allefenes/ParallelDeltaRobot/DeltaRobotV2/docs/guvenlik-gereksinimleri.md

# Güvenlik gereksinimleri ve izlenebilirlik

Her güvenlik gereksinimi en az bir otomatik testle kanıtlanır. Test plan risk tabanlıdır: kapsama yüzdesi bilgi amaçlıdır, asıl ölçüt bu tablodur. Gereksinim ancak ilgili katmanların hepsinde testi geçtiğinde "kanıtlandı" sayılır.

Katmanlar: **Ç** çekirdek (`core/`, F1), **S** sunucu 1. kapı (`ros2_ws/src/delta_server`, F3), **K** Pi kenarı son kapı (`edge/`, F3), **D** donanım kabul testi (F5, [kabul-testleri.md](kabul-testleri.md)). **U** uçtan uca Compose testi (`tools/e2e.sh`, F3) ek kanıttır.

Test adları gereksinim numarasıyla başlar; tam liste `grep -r "G5_" edge/tests ros2_ws/src/delta_server/test` ile çıkar.

| No  | Gereksinim | Katman  | Kanıtlayan testler (örnek) | Durum |
| --- | --- | --- | --- | --- |
| G1  | Motor açı limiti (−70° … +150°) dışındaki hiçbir açı servolara ulaşmaz | Ç, S, K | `Kinematics.MotorLimitRejected`; `test_G1_motor_limit_rejected*`; `Gate.G1_JointLimitExactEdgesAccepted`, `Edge.G1_LimitEdgesReachableNothingBeyondReachesDriver` (6); U: son kapı reddi | ✔ |
| G2  | Rot başı yanal açısı 13°'yi aşan konum kabul edilmez | Ç, S | `Kinematics.RodTiltLimitRejected`; `test_G2_rod_tilt_rejected`; launch_testing G2 reddi; U: 1. kapı reddi | ✔ |
| G3  | Erişilemeyen hedef reddedilir, hareket başlamaz | Ç, S | `Kinematics.UnreachablePointRejected`; `test_G3_*` (4) | ✔ |
| G4  | NaN, sonsuz ya da bozuk veri motorlara ulaşmaz | Ç, S, K | `Kinematics.NonFiniteInputRejected`; `test_G4_*` (5); `Gate.G4_*`, `FuzzRegressions.G4_CorpusAndRegressionInputsAreSafe` (7); libFuzzer ~175 bin girdi, bulgu yok | ✔ |
| G5  | Eklem hız ve ivme sınırları aşılamaz (aşan yörünge reddedilir) | S, K | `test_G5_*` (4), `test_auto_duration_respects_g5_limits`; `Gate.G5_*` (9) | ✔ |
| G6  | Sunucu kalp atışı kesilirse robot hareketin ortasında bile en geç T_stop içinde durup konumu tutar | K, U | `Edge.G6_*` (5); U: hareket ortasında kalp atışı kaybı, kara delik, sunucu çökmesi (HOLD ölçülen ~209 ms) | ✔ (yazılım), D: H2 F5 |
| G7  | Kalp atışı T_off süresince gelmezse tork kapanır ve elektromıknatıs tanımlı güvenli duruma geçer | K, U | `Edge.G7_*` (4); U: TORQUE_OFF ölçülen ~1029 ms; Pi SIGTERM'de tork + mıknatıs kapanır | ✔ (yazılım), D: H2 F5 |
| G8  | Kapıdan geçmeyen yörünge hiç başlamaz; neden sunucuya bildirilir | K, U | `Edge.G8_*` (5); U: 1. kapıyı atlayan limit dışı yörünge → `fault`, robot hareketsiz | ✔ |
| G9  | Sıcaklık, yük ya da gerilim sınırı aşılınca hareket durur | K | `Edge.G9_*` (10, MockDriver ile) | ✔ (yazılım), D: F5 |
| G10 | Seri hattı yalnız kenar servisi kullanır (tek sahip) | K | `Architecture.G10_*` (2, kaynak taraması) | ✔ |
| G11 | Kullanıcı kodu sandbox'ta ağa çıkamaz, kaynak sınırını aşamaz, dosya sistemine yazamaz | S | `sandbox/tests/g11/test_G11_*` 59 (gerçek konteyner: ağ, dosya sistemi, bellek, süreç, CPU, çıktı, yetki, koşucu protokolü), `test_job_backpressure` (Docker'sız tıkanma regresyonu); uçtan uca: sandbox ağsız, sonsuz döngü zaman aşımı | ✔ |
| G12 | Fiziksel acil stop, yazılımdan bağımsız olarak servo gücünü keser | D | F5 kabul testi H1 | F5 |
| G13 | Pi çöker ya da donarsa servo gücü donanımca en geç 0.5 s içinde kesilir (varsayım) | K, D | K: `LifePulse.G13_*` (3, darbe döngü ölünce durur); D: F5 kabul testi H13 | K ✔, D F5 |
| G14 | Mıknatıs ucu (P − 15 mm) tabla/zemin üst yüzünün altına inemez (çarpışma); sınır robot.yaml'dan (zemin + tabla kalınlığı) | S | `test_G14_*` (3), simülasyon API testleri, Playwright `limit_rejections` | ✔ |

**Kapanış durumu (2026-11-12):** 12 / 14 gereksinim tüm yazılım katmanlarında testle kanıtlandı (G1–G11, G14). G13'ün yazılım tarafı kanıtlandı; G12 ve G13'ün donanım tarafı ile G6, G7, G9'un gerçek donanım süre ölçümleri F5 ile askıda.

**Durum (F3 sonu):** 10 / 13 gereksinim tüm yazılım katmanlarında testle kanıtlandı (G1–G10). G13'ün yazılım tarafı (yaşam darbesi) kanıtlandı, donanım tarafı F5'te. G11 F4'te, G12 F5'te. G6, G7 ve G9'un gerçek donanımdaki süre ölçümleri F5 kabul testlerindedir.

**Kritik modüllerde mutasyon skoru:** 130 / 131 (%99.2; kapı, bekçi, protokol). Kalan tek mutant eşdeğer (`gate.cpp:32`, sonucu değiştirmiyor).

## Süre değerleri

| Değer  | Ayar | Ölçülen (sanal Pi, Compose) | Not |
| --- | --- | --- | --- |
| T_stop | 200 ms (`edge/config/edge.yaml`) | ~209 ms | Telemetri aralığı 50 ms ölçüme eklenir |
| T_off  | 1000 ms | ~1029 ms | |
| G13 | 0.5 s (varsayım, 74HC123 RC) | F5 | Yaşam darbesi 100 Hz döngüde 50 Hz kare dalga |

**F4 eki:** G14 F4'te API sözleşmesi yazılırken bulundu: çalışma alanının kinematik alt sınırı (P −250 mm) mıknatıs ucunu zemine (−240) indirebiliyordu ve 1. kapıda zemin denetimi yoktu. Süpervizöre eklendi.
