allefenes/ParallelDeltaRobot/DeltaRobotV2/docs/img/cad/eklem.png

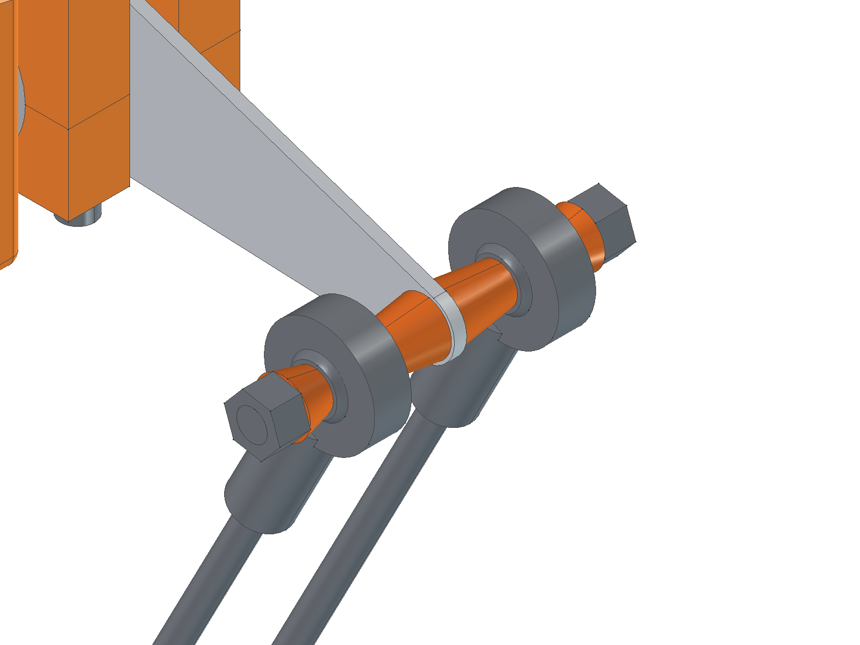
DeltaRobotV2/docs/img/cad/eklem.png
