allefenes/ParallelDeltaRobot/DeltaRobotV2/docs/img/cad/iso.png

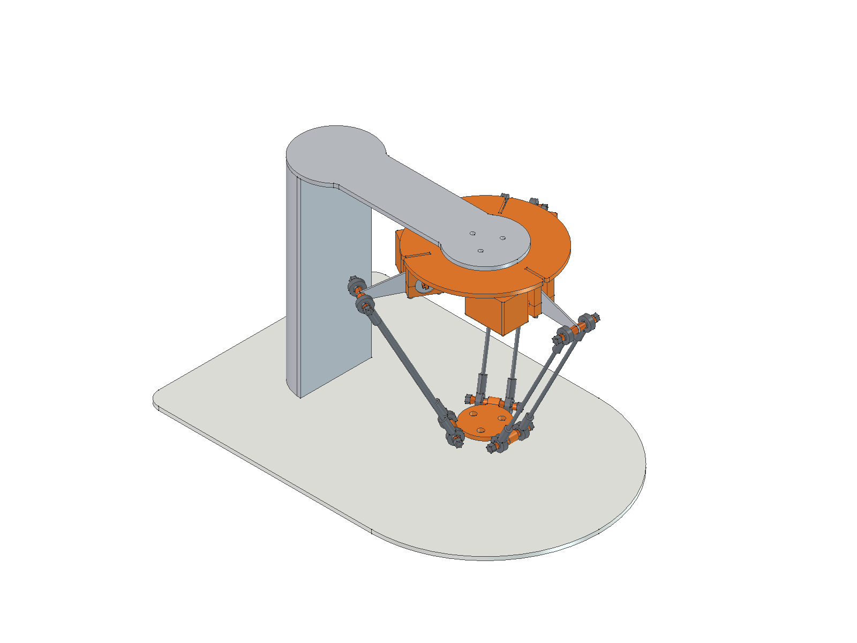
DeltaRobotV2/docs/img/cad/iso.png
