allefenes/ParallelDeltaRobot/DeltaRobotV2/docs/img/cad/kol1_yukari.png

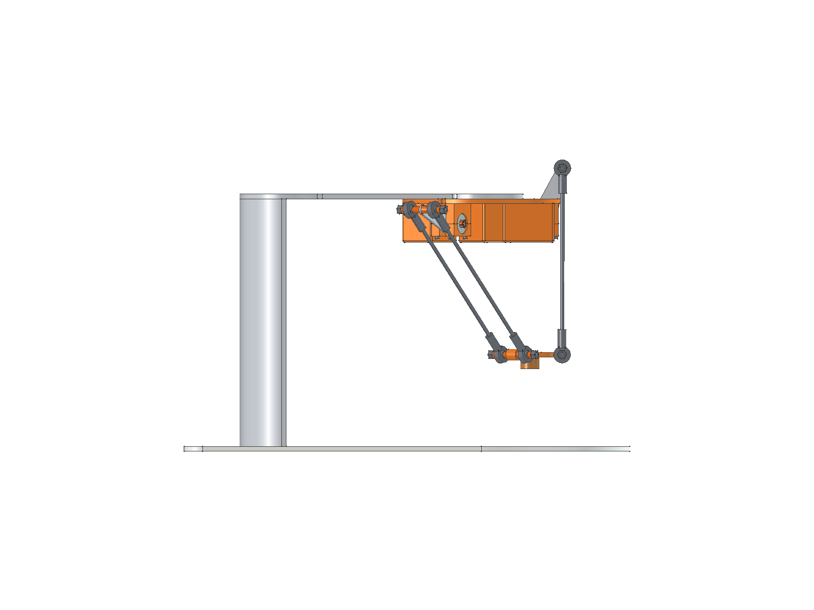
DeltaRobotV2/docs/img/cad/kol1_yukari.png
