allefenes/ParallelDeltaRobot/DeltaRobotV2/docs/img/cad/kol1_yukari_iso.png

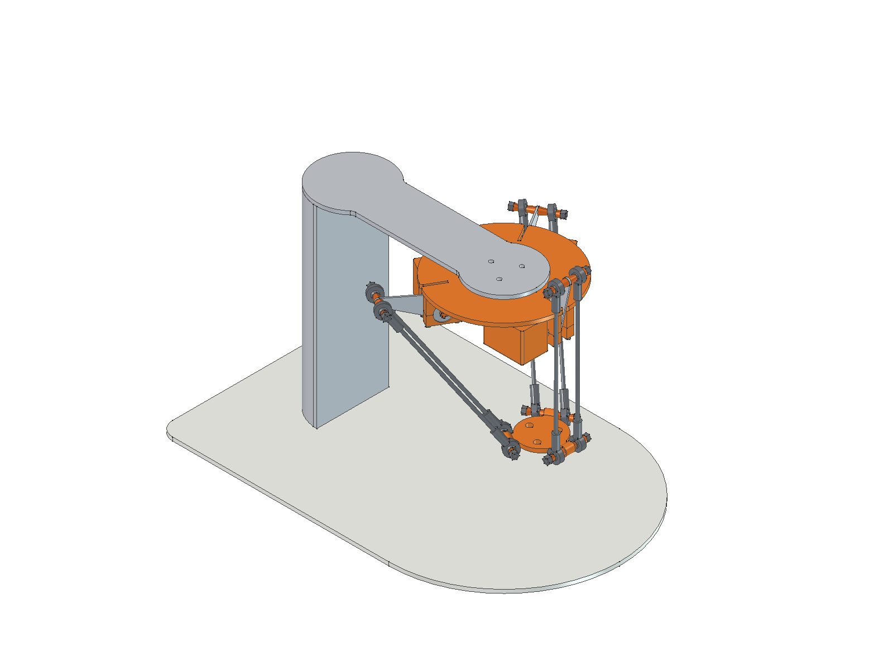
DeltaRobotV2/docs/img/cad/kol1_yukari_iso.png
