allefenes/ParallelDeltaRobot/DeltaRobotV2/docs/img/cad/kol1_yukari_yakin.png

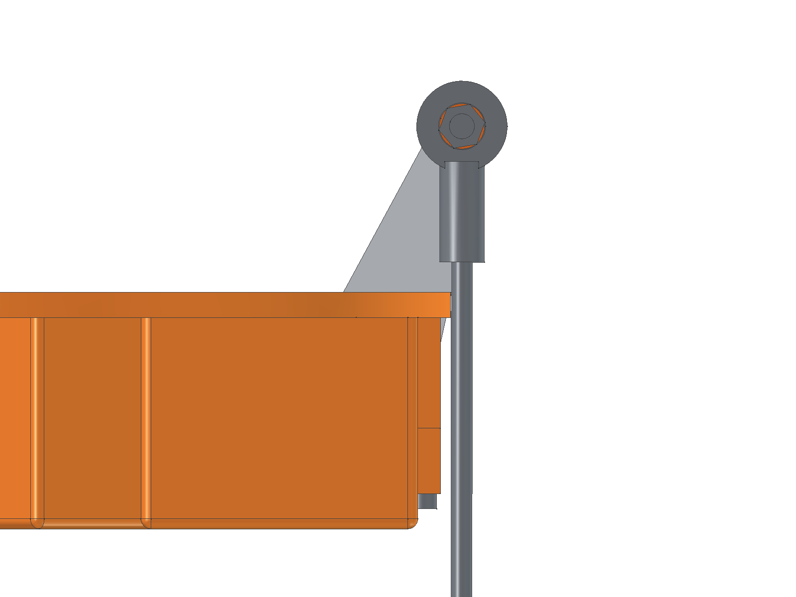
DeltaRobotV2/docs/img/cad/kol1_yukari_yakin.png
