allefenes/ParallelDeltaRobot/DeltaRobotV2/docs/img/cad/mekanizma.png

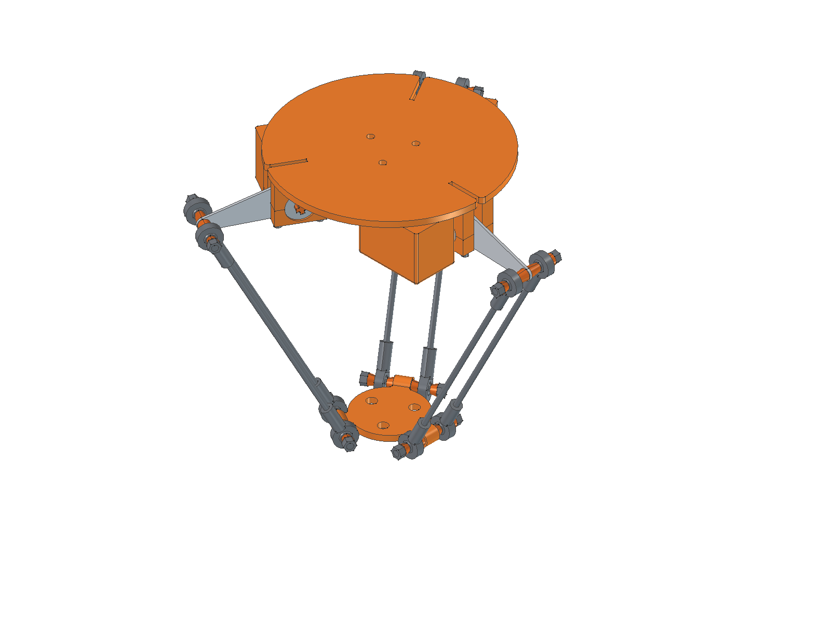
DeltaRobotV2/docs/img/cad/mekanizma.png
