allefenes/ParallelDeltaRobot/DeltaRobotV2/docs/img/cad/motor_kutulari_alttan.png

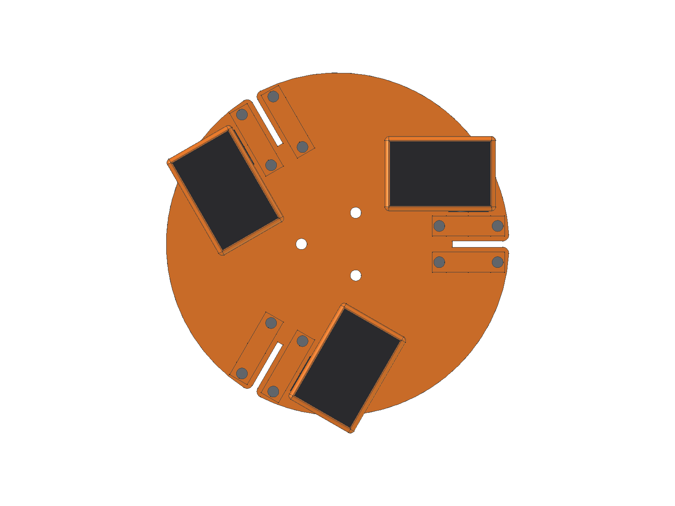
DeltaRobotV2/docs/img/cad/motor_kutulari_alttan.png
