allefenes/ParallelDeltaRobot/DeltaRobotV2/docs/img/cad/motor_kutusu_yakin.png

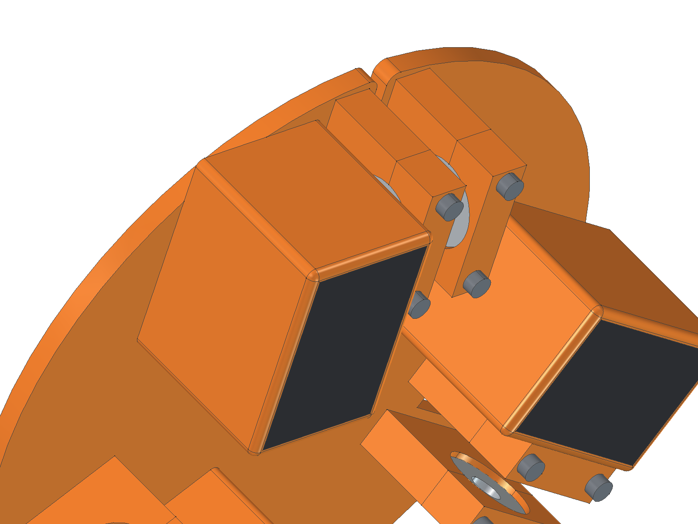
DeltaRobotV2/docs/img/cad/motor_kutusu_yakin.png
