allefenes/ParallelDeltaRobot/DeltaRobotV2/docs/img/cad/parcalar/01_pom_taban.png

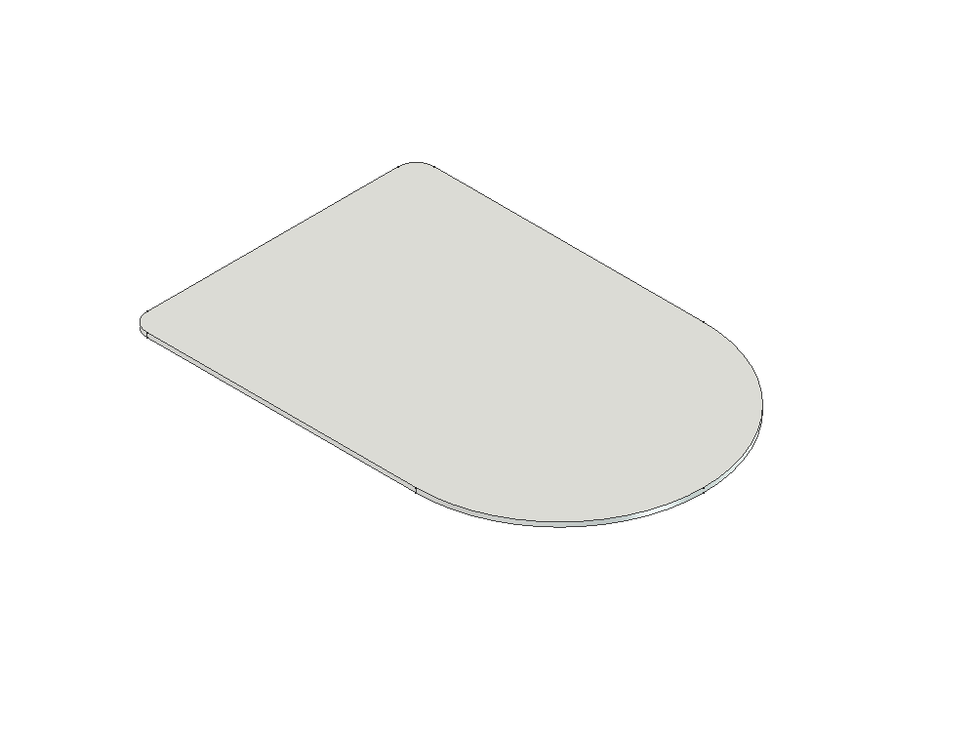
DeltaRobotV2/docs/img/cad/parcalar/01_pom_taban.png
