allefenes/ParallelDeltaRobot/DeltaRobotV2/docs/img/cad/parcalar/02_sutun_tavan.png

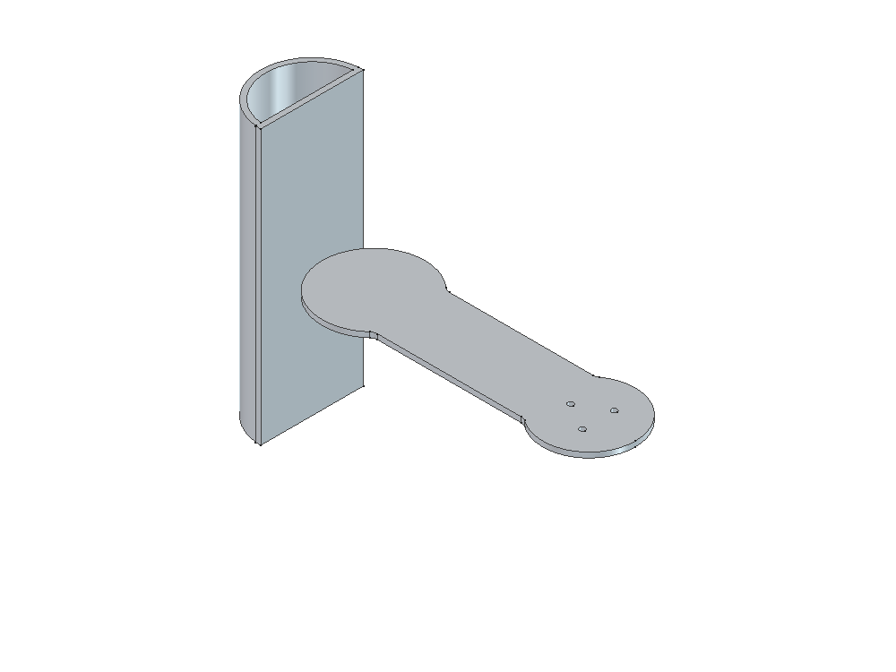
DeltaRobotV2/docs/img/cad/parcalar/02_sutun_tavan.png
