allefenes/ParallelDeltaRobot/DeltaRobotV2/docs/img/cad/parcalar/03_motor_govdesi.png

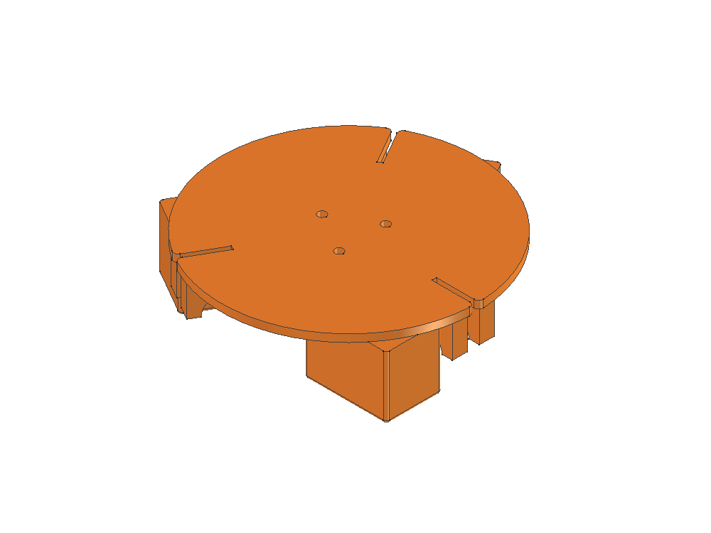
DeltaRobotV2/docs/img/cad/parcalar/03_motor_govdesi.png
