allefenes/ParallelDeltaRobot/DeltaRobotV2/docs/img/cad/parcalar/03_motor_govdesi_ust_plaka.png

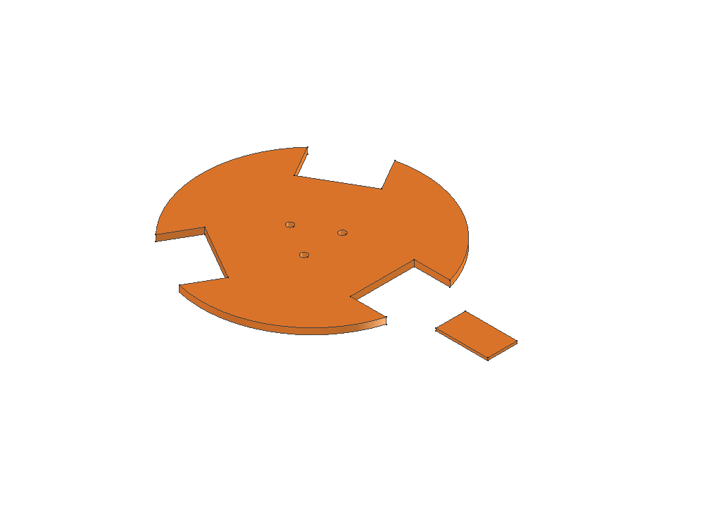
DeltaRobotV2/docs/img/cad/parcalar/03_motor_govdesi_ust_plaka.png
