allefenes/ParallelDeltaRobot/DeltaRobotV2/docs/img/cad/parcalar/04_rulman_kapagi_vida.png

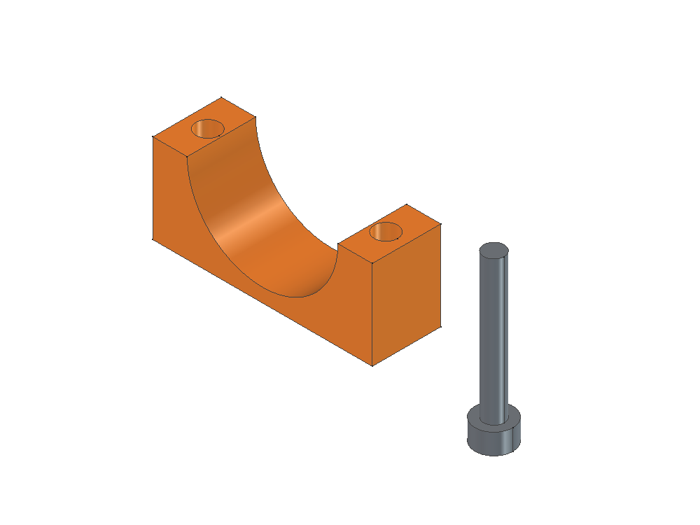
DeltaRobotV2/docs/img/cad/parcalar/04_rulman_kapagi_vida.png
