allefenes/ParallelDeltaRobot/DeltaRobotV2/docs/img/cad/parcalar/05_motor_rulman_mil.png

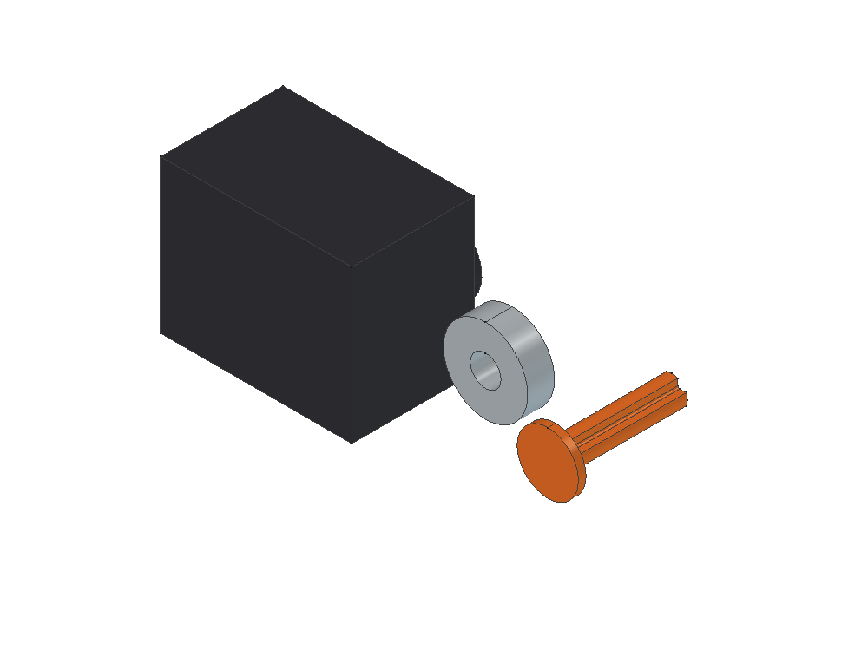
DeltaRobotV2/docs/img/cad/parcalar/05_motor_rulman_mil.png
