allefenes/ParallelDeltaRobot/DeltaRobotV2/docs/img/cad/parcalar/06_kisa_kol.png

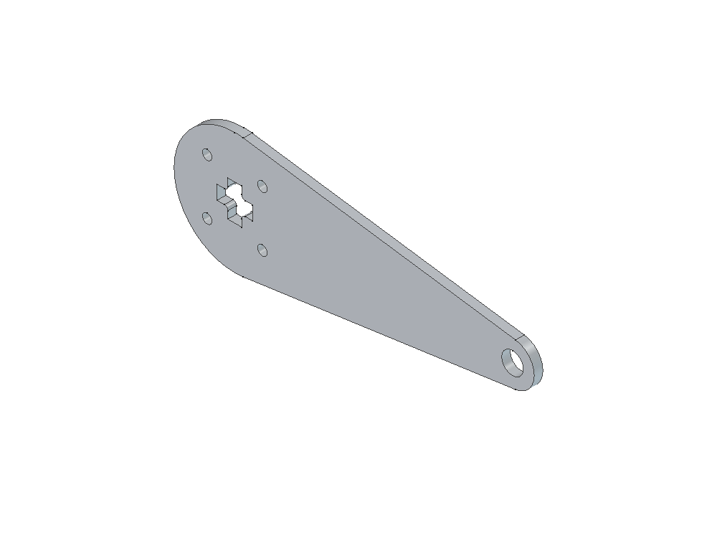
DeltaRobotV2/docs/img/cad/parcalar/06_kisa_kol.png
