allefenes/ParallelDeltaRobot/DeltaRobotV2/docs/img/cad/parcalar/07_eklem_pim_burc_somun_kure.png

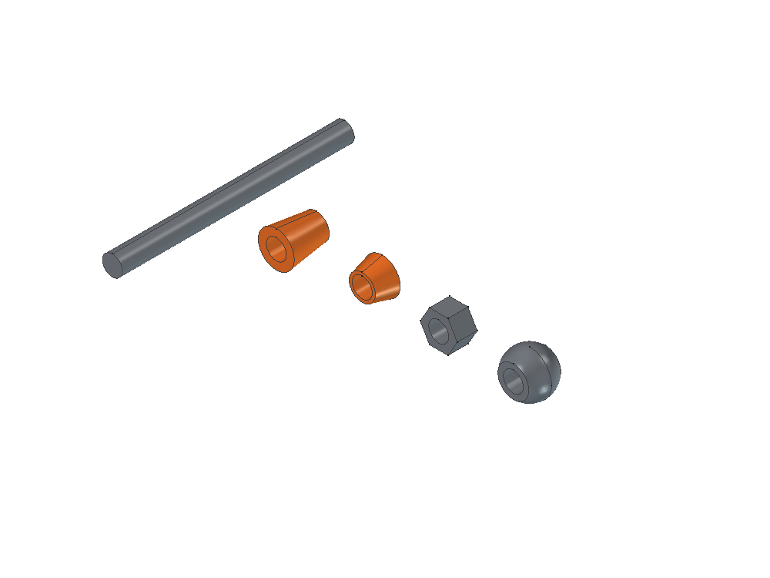
DeltaRobotV2/docs/img/cad/parcalar/07_eklem_pim_burc_somun_kure.png
