allefenes/ParallelDeltaRobot/DeltaRobotV2/docs/img/cad/parcalar/08_uzun_kol_rot_basi.png

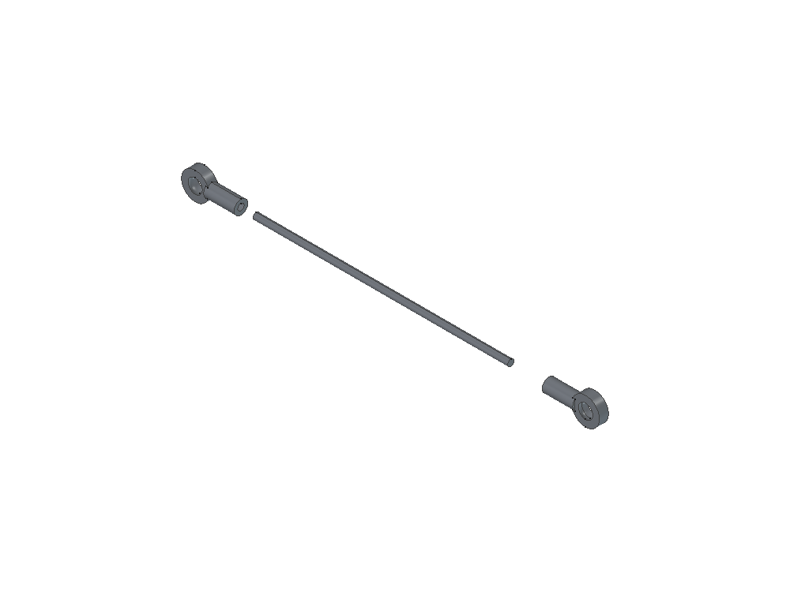
DeltaRobotV2/docs/img/cad/parcalar/08_uzun_kol_rot_basi.png
