allefenes/ParallelDeltaRobot/DeltaRobotV2/docs/img/cad/parcalar/09_platform_miknatis.png

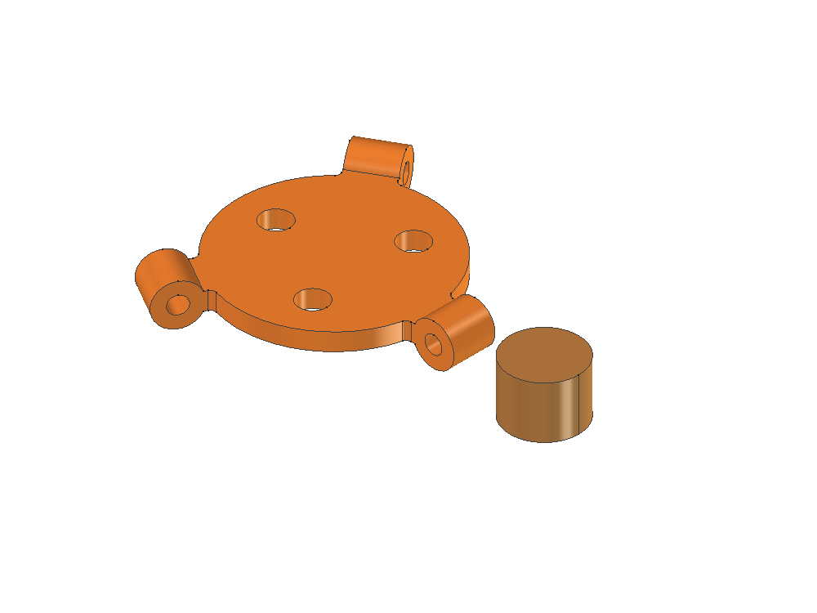
DeltaRobotV2/docs/img/cad/parcalar/09_platform_miknatis.png
