allefenes/ParallelDeltaRobot/DeltaRobotV2/docs/img/cad/ust.png

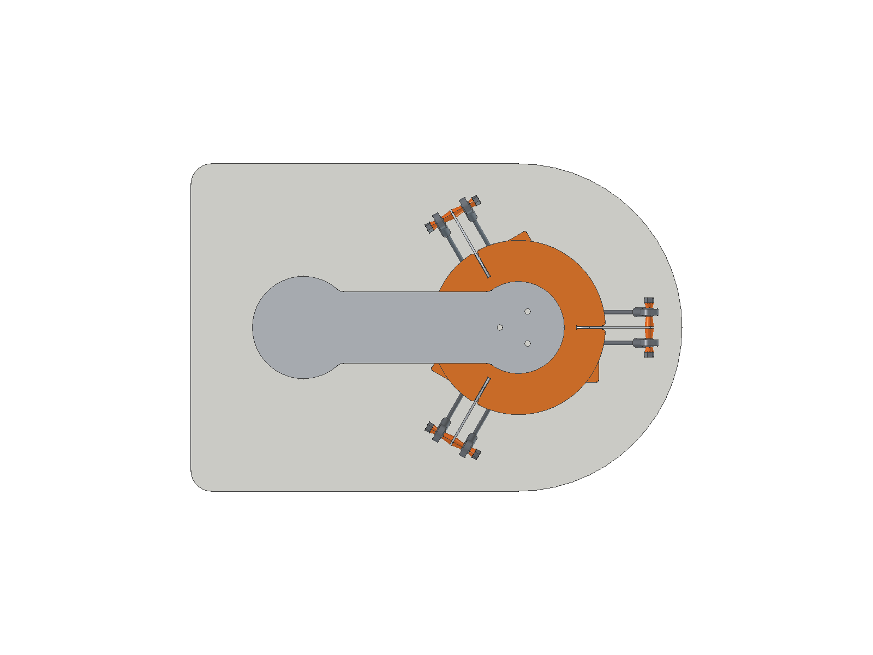
DeltaRobotV2/docs/img/cad/ust.png
