allefenes/ParallelDeltaRobot/DeltaRobotV2/docs/img/cad/yan.png

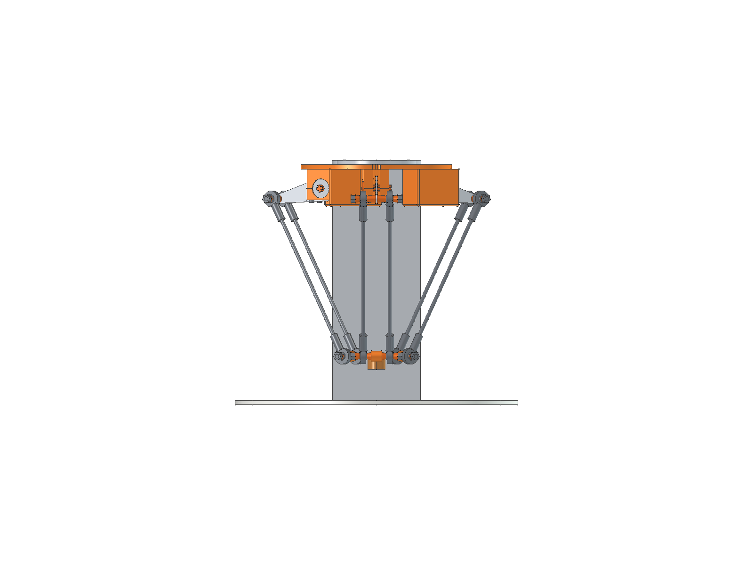
DeltaRobotV2/docs/img/cad/yan.png
