allefenes/ParallelDeltaRobot/DeltaRobotV2/ros2_ws/screenshots/01_home.png

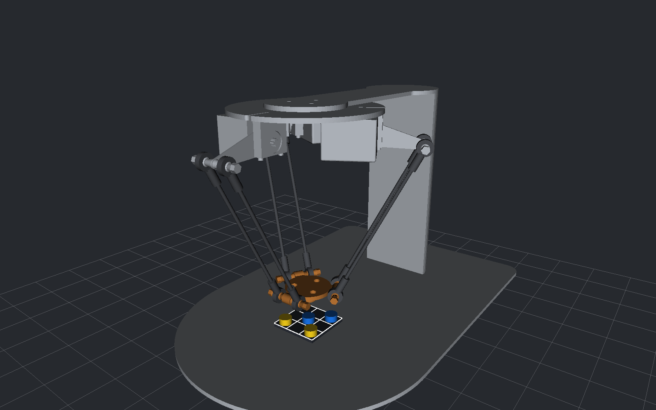
DeltaRobotV2/ros2_ws/screenshots/01_home.png
