allefenes/ParallelDeltaRobot/DeltaRobotV2/web/screenshots/ui.png

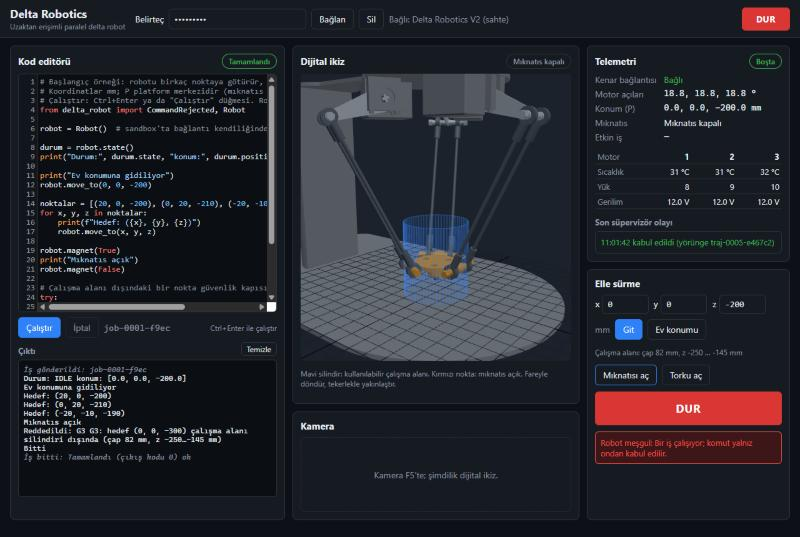
DeltaRobotV2/web/screenshots/ui.png
