allefenes/ParallelDeltaRobot/KilavuzDeltaRobotics/theme/hq720.png

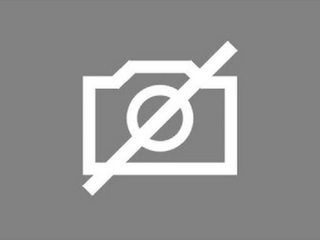
KilavuzDeltaRobotics/theme/hq720.png
