allefenes/ParallelDeltaRobot/DeltaRobotV2/hardware/bom.md

# Malzeme listesi (BOM)

Bu dosya üretilir; elle düzenlemeyin. Kaynak: [bom.yaml](bom.yaml) (elle tutulan alanlar) ve CAD (`cad/out/parts.json`: adet ve kütle). Makine okunur sürüm: [bom.csv](bom.csv).

Üretmek: `docker compose run --rm dev python3 tools/bom.py`

**Durum: F5 askıda (2026-11-12).** Hiçbir kalem satın alınmadı ya da üretilmedi. Elektronik kalemler (donanım bekçisi, mıknatıs sürücüsü, acil stop, Pi beslemesi) ve kutu/kamera tasarımı kesinleşmedi; fiyat ve tedarikçi alanları boştur.

| No  | Ad | Kategori | Malzeme / özellik | Adet | Birim kütle (g) | Toplam kütle (g) | Üretim | Tedarikçi | Birim fiyat (TL) | Durum | Kaynak | Not |
| --- | --- | --- | --- | ---- | --- | --- | --- | --- | --- | --- | --- | --- |
| 1 | POM taban | Gövde | POM, 5 mm levha | 1 | 1004.2 | 1004.2 | CNC / lazer kesim, köşeler R20 | TBD | | V1 (olduğu gibi) | CAD | Dış ölçüler varsayım |
| 2 | Sütun (D kesit) | Gövde | Al 7075, 5 mm | 1 | 897.4 | 897.4 | Lazer kesim + kıvırma + kaynak | TBD | | V1 (olduğu gibi) | CAD | 7075 kaynağa pek uygun değil; yeniden üretimde 6061/5083 |
| 3 | Tavan levhası | Gövde | Al 7075, 5 mm | 1 | 321.3 | 321.3 | Lazer kesim, geçişler R8; sütuna kaynaklı | TBD | | V1 (olduğu gibi) | CAD | Robot ucu R45 (varsayım) |
| 4 | Kısa kol | Gövde | Al 7075, 2 mm | 3 | 8.4 | 25.3 | Lazer kesim; artı delik iç köşeleri R0.8  | TBD | | V1 (olduğu gibi) | CAD | Merkezden merkeze 64 mm |
| 10  | Motor gövdesi (tek parça)  | 3B baskı | PLA, %20 doluluk | 1 | 116.0 | 116.0 | 3B baskı | kendi üretim | | V2'de değişti | CAD | Üst plaka + 3 motor kutusu + 6 rulman yatağı üst yarısı |
| 11  | Rulman yatağı alt kapağı | 3B baskı | PLA, %20 doluluk | 6 | 1.4 | 8.5 | 3B baskı | kendi üretim | | V1 (olduğu gibi) | CAD | Yatağın alt yarısı; alttan takılır, 2 vidayla alttan sıkılır |
| 12  | Çıkış mili (artı kesit) | 3B baskı | PLA, %100 doluluk | 3 | 1.9 | 5.8 | 3B baskı | kendi üretim | | V1 (olduğu gibi) | CAD | Uçları Ø8 dairede, 608ZZ'ye oturur |
| 13  | İç burç (konik) | 3B baskı | PLA %100 (varsayım) | 12 | 0.3 | 3.1 | 3B baskı ya da torna | kendi üretim | | V1 (olduğu gibi) | CAD | 6 × 10 mm (kısa kol) + 6 × 5 mm (platform); Ø9 → Ø6.5 |
| 14  | Dış burç (konik) | 3B baskı | PLA %100 (varsayım) | 12 | 0.2 | 2.0 | 3B baskı ya da torna | kendi üretim | | V1 (olduğu gibi) | CAD | 5 mm; dar ucu rot başına bakar |
| 15  | Uç platform | 3B baskı | PLA, %20 doluluk | 1 | 8.1 | 8.1 | 3B baskı | kendi üretim | | V1 (olduğu gibi) | CAD | R35 × 5 mm, 3 kulak, 3 süs deliği, mıknatıs cebi |
| 20  | Servo motor | Satın alma | Dynamixel AX-12A | 3 | 54.6 | 163.8 | satın alma | TBD | | V1 (olduğu gibi) | CAD | Yeniden kurulumda motor değişebilir |
| 21  | Rulman | Satın alma | 608ZZ (8 × 22 × 7) | 6 | 12.0 | 72.0 | satın alma | TBD | | V1 (olduğu gibi) | CAD | |
| 22  | Rot başı (dişi M5) | Satın alma | DIN ISO 12240-4 K, SI5 benzeri | 12 | 12.0 | 144.0 | satın alma | TBD | | V1 (olduğu gibi) | CAD | Kütle katalog değeri (~12 g) |
| 23  | Elektromıknatıs | Satın alma | Ø20 × 15 mm, 12 V (varsayım) | 1 | 35.0 | 35.0 | satın alma | TBD | | Varsayım | CAD | Model ve tutma kuvveti bilinmiyor |
| 30  | Uzun kol saplaması | Bağlantı elemanı | M5 saplama, çelik, 167 mm | 6 | 18.6 | 111.6 | Saplama kesimi | TBD | | V1 (olduğu gibi) | CAD | Rot başlarına 10'ar mm girer |
| 31  | Eklem pimi | Bağlantı elemanı | M5 saplama, çelik, ~60 mm | 6 | 8.9 | 53.6 | Saplama kesimi | TBD | | V2'de değişti | CAD | Yeni istif: 58 mm |
| 32  | Fiber somun | Bağlantı elemanı | M5 DIN 985 | 12 | 1.4 | 16.8 | satın alma | TBD | | V1 (olduğu gibi) | CAD | |
| 33  | Kapak vidası | Bağlantı elemanı | M3 × 20, alttan (varsayım) | 12 | 1.7 | 20.6 | satın alma | TBD | | Varsayım | CAD | |
| 34  | Gövde-tavan cıvatası | Bağlantı elemanı | M5 × 12 + somun (varsayım) | 3 | 3.0 | 9.0 | satın alma | TBD | | Varsayım | elle | CAD'de çizilmedi |
| 35  | Sütun-taban bağlantısı | Bağlantı elemanı | M5 cıvata + somun (varsayım) | 4 | 4.0 | 16.0 | satın alma | TBD | | Varsayım | elle | Bağlantı şekli bilinmiyor; CAD'de çizilmedi |
| 36  | Isıyla gömülen insert | Bağlantı elemanı | M3, pirinç, Ø4.6 × 5.7 mm (varsayım) | 12 | 0.5 | 5.5 | satın alma; havya ile PLA'ya gömülür | TBD | | V1 (olduğu gibi) | CAD | Rulman yatağı üst yarılarında; kapak vidaları buna girer |
| 40  | Robot bilgisayarı | Elektronik | Raspberry Pi 4B (8 GB) | 1 | 46.0 | 46.0 | satın alma | TBD | | V1 (olduğu gibi) | elle | İnce kenar: delta_edge servisi |
| 41  | Güç kaynağı | Elektronik | 12 V, ≥5 A, LED tipi anahtarlamalı | 1 | | | satın alma | TBD | | V1 (olduğu gibi) | elle | Akım değeri varsayım |
| 42  | Pi beslemesi | Elektronik | 12 V → 5 V / 3 A DC-DC (varsayım) | 1 | | | satın alma | TBD | | Varsayım | elle | Acil stop Pi beslemesini kesmez |
| 43  | Dynamixel arayüzü | Elektronik | U2D2 ya da 74LS241 yarım-dupleks devre | 1 | | | satın alma / kendi devre | TBD | | Varsayım | elle | V1'deki devre bilinmiyor |
| 44  | Elektromıknatıs sürücüsü | Elektronik | Lojik seviyeli MOSFET + serbest dönüş diyotu | 1 | | | satın alma | TBD | | Varsayım | elle | Güvenli durum F3'te |
| 45  | Acil stop butonu | Elektronik | Mantar buton, NC + NO kontak | 1 | | | satın alma | TBD | | V2'de değişti | elle | Güç yolunu keser, Pi GPIO'ya bildirir |
| 46  | Kamera | Elektronik | USB ya da CSI kamera | 1 | | | satın alma | TBD | | V1 (olduğu gibi) | elle | WebRTC yayını Pi'den |
| 47  | Donanım bekçisi monostable | Elektronik | 74HC123 yeniden tetiklenebilir monostable + RC (≈0.5 s, varsayım) | 1 | | | satın alma | TBD | | V2'de değişti | elle | Pi yaşam darbesi kesilirse servo gücünü keser (G13) |
| 48  | Servo güç anahtarı | Elektronik | Lojik seviyeli N-MOSFET (≥10 A) ya da 12 V röle modülü, serbest dönüş diyotu | 1 | | | satın alma | TBD | | V2'de değişti | elle | Acil stopla seri; donanım bekçisi sürer |
| 49  | Bekçi pasifleri | Elektronik | Direnç, kondansatör, gate direnci, LED (takım) | 1 | | | satın alma | TBD | | V2'de değişti | elle | Donanım bekçisi devresi |
| 50  | PLA filament | Sarf | 1.75 mm PLA | 1 | | | satın alma | TBD | | V1 (olduğu gibi) | elle | Toplam baskı kütlesi BOM toplamından |

## Kategori toplamları (kütlesi bilinen kalemler)

| Kategori | Kütle (g) |
| --- | --- |
| Gövde | 2248.2 |
| 3B baskı | 143.5 |
| Satın alma | 414.8 |
| Bağlantı elemanı | 233.1 |
| Elektronik | 46.0 |
| Toplam | 3085.6 |
