allefenes/ParallelDeltaRobot/DeltaRobotV2/cad/out/delta_v2.FCStd

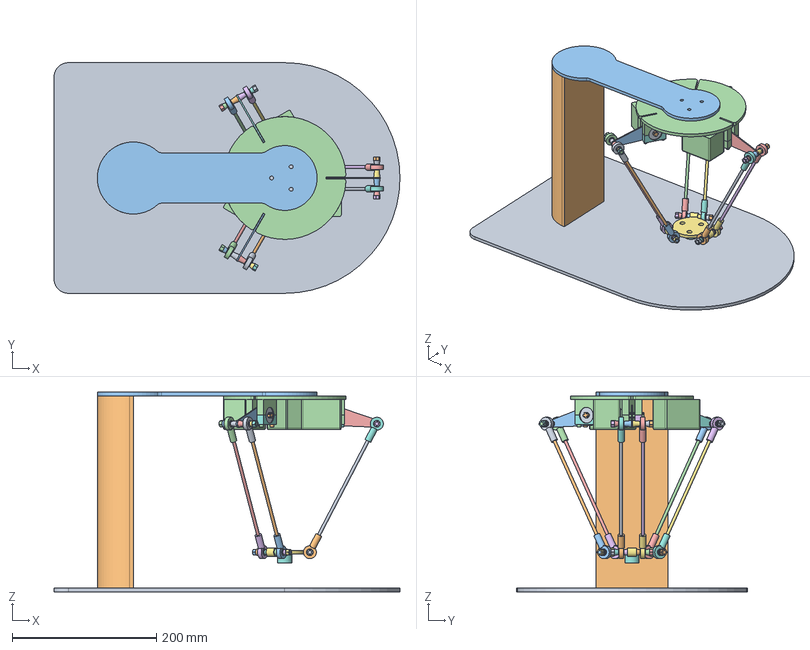
[picture p28: CAD file, 2026-11-11]
DeltaRobotV2/cad/out/delta_v2.FCStd
480.0 x 320.0 x 277.0 mm
base_pom_base_0
base_column_1
base_ceiling_2
base_motor_housing_3
base_motor_1_4
base_bearing_cap_1_5
base_bearing_1_6
base_cap_screw_1_7
base_insert_1_8
base_cap_screw_1_9
base_insert_1_10
base_bearing_cap_1_11
base_bearing_1_12
base_cap_screw_1_13
base_insert_1_14
base_cap_screw_1_15
base_insert_1_16
base_motor_2_17
base_bearing_cap_2_18
base_bearing_2_19
base_cap_screw_2_20
base_insert_2_21
base_cap_screw_2_22
base_insert_2_23
base_bearing_cap_2_24
base_bearing_2_25
base_cap_screw_2_26
base_insert_2_27
base_cap_screw_2_28
base_insert_2_29
base_motor_3_30
base_bearing_cap_3_31
base_bearing_3_32
base_cap_screw_3_33
base_insert_3_34
base_cap_screw_3_35
base_insert_3_36
base_bearing_cap_3_37
base_bearing_3_38
base_cap_screw_3_39
base_insert_3_40
base_cap_screw_3_41
base_insert_3_42
bicep_1_output_shaft_0
bicep_1_bicep_plate_1
bicep_1_pin_2
bicep_1_bushing_inner_3
bicep_1_rod_end_ball_4
bicep_1_bushing_outer_5
bicep_1_nut_6
bicep_1_bushing_inner_7
bicep_1_rod_end_ball_8
bicep_1_bushing_outer_9
bicep_1_nut_10
bicep_2_output_shaft_0
bicep_2_bicep_plate_1
bicep_2_pin_2
bicep_2_bushing_inner_3
bicep_2_rod_end_ball_4
bicep_2_bushing_outer_5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
