allefenes/ParallelDeltaRobot/DeltaRobotV2/cad/out/meshes/base.stl

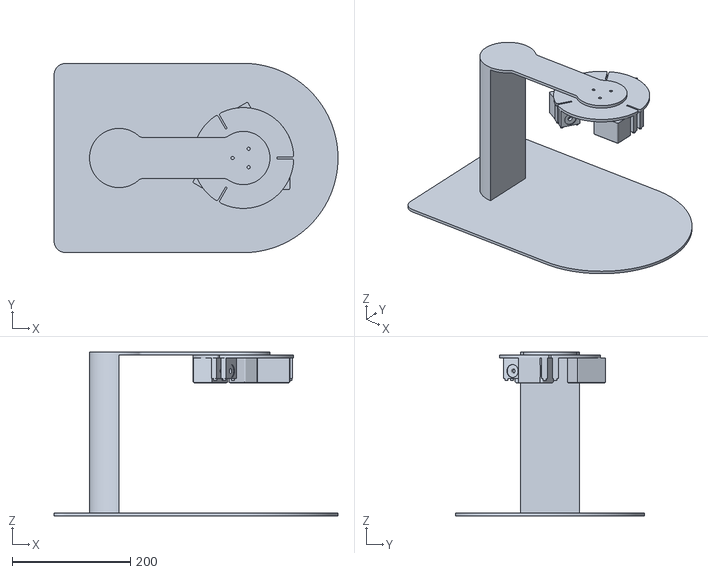
[picture p29: CAD file, 2026-11-11]
DeltaRobotV2/cad/out/meshes/base.stl
480.0 x 320.0 x 277.0
