allefenes/ParallelDeltaRobot/DeltaRobotV2/cad/out/meshes/platform.stl

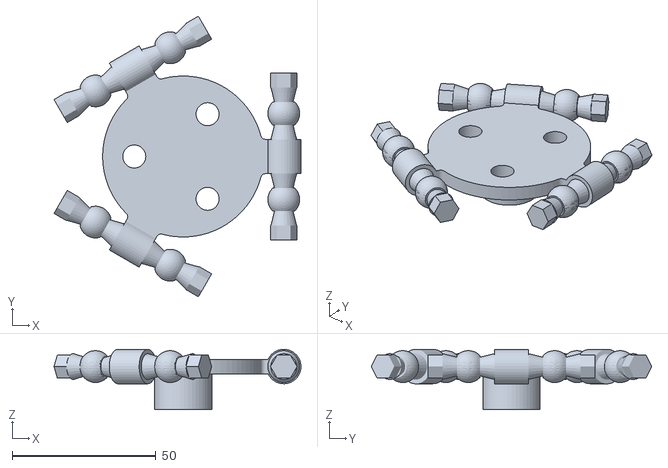
[picture p31: CAD file, 2026-11-11]
DeltaRobotV2/cad/out/meshes/platform.stl
85.9 x 97.6 x 21.0
