allefenes/ParallelDeltaRobot/DeltaRobotV2/cad/out/meshes/bicep_2.stl

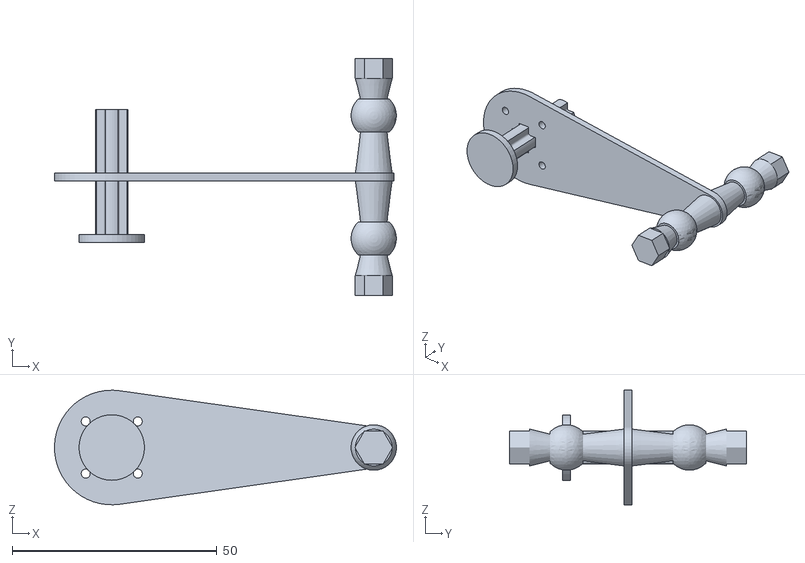
[picture p32: CAD file, 2026-11-11]
DeltaRobotV2/cad/out/meshes/bicep_2.stl
83.5 x 58.0 x 28.0
