allefenes/ParallelDeltaRobot/DeltaRobotV2/cad/out/meshes/bicep_1.stl

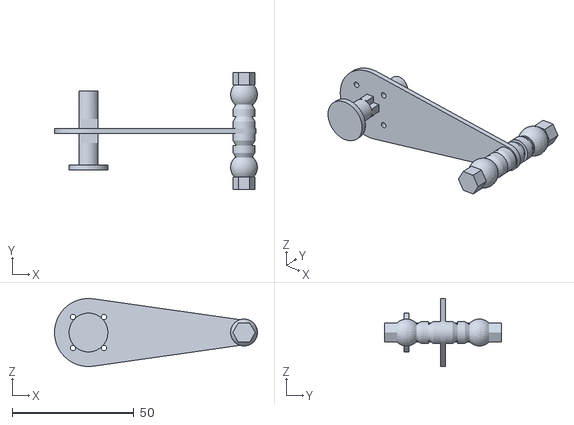
[picture p33: CAD file, 2026-11-11]
DeltaRobotV2/cad/out/meshes/bicep_1.stl
83.5 x 48.0 x 28.0
