allefenes/ParallelDeltaRobot/DeltaRobotV2/cad/out/meshes/forearm_1_b.stl

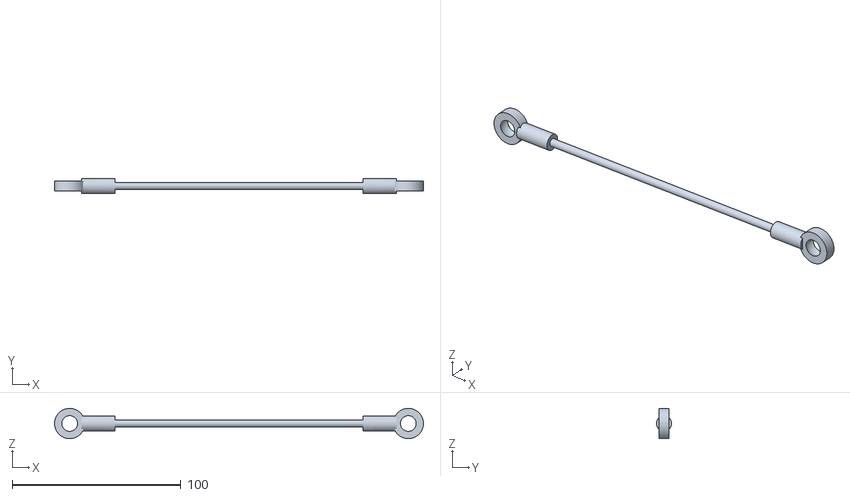
[picture p34: CAD file, 2026-11-11]
DeltaRobotV2/cad/out/meshes/forearm_1_b.stl
219.0 x 9.00 x 18.0
