allefenes/ParallelDeltaRobot/(list of files, cad)

Other CAD files:
DeltaRobotV2/cad/out/meshes/forearm_2_b.stl
