allefenes/ParallelDeltaRobot/(commit log)

2026-11-11 DeltaRobotV2: F0.5 CAD modeli, montaj ve görseller
    - config/robot.yaml: tek ölçü kaynağı (kaynak etiketli: json/kullanıcı/türetilmiş/varsayım)
    - cad/: FreeCAD 1.1 betikleri; tüm parçalar parametrik, her hareketli bağ ayrı gövde
    - Montaj kinematikle doğrulandı (R65 / 64 / 201 / R35, 30 mm saplama aralığı), çakışma yok
    - Bağ mesh'leri (STL, yerel çerçevede), kütle/atalet (SI) ve kontrol raporu
    - Malzemeye göre renkli görseller (docs/img/cad)
    - tools/cad.sh; belgeler ve kurulum planı güncellendi
2026-11-11 CAD: rapor dosyaları LF satır sonuyla yazılır
2026-11-11 DeltaRobotV2: F0.5 CAD revizyon 2 (kullanıcı düzeltmeleri)
    - Sütun D kesitli (açık yüz 5 mm levhayla kapalı)
    - Motor gövdesi üst plakasında her kol için dikdörtgen açıklık; 1. kol -69.6°'de çakışmasız
    - P'den mıknatıs ucuna 15 mm kısıtı: pimler platform orta düzleminde, mıknatıs 2.5 mm cepte
    - Tavanın robot ucu R45; bağlantı delikleri merkeze yakın (R18), üst plakada aynı desen
    - Rot başı küresi ayrı parça (gövde küre etrafında eğilir); ek kontrol pozu (check_poses)
    - Parça önizlemeleri (19 parça, 9 görsel), görseller 8 bit RGB
    - docs/ilerleme.md: sayılarla faz ilerlemesi; belgeler ve kurulum planı güncellendi
2026-11-11 DeltaRobotV2: F0.5 CAD revizyon 3 (kullanıcı düzeltmeleri)
    - Motor gövdesi tek parça: üst plaka + motor kutuları (motor dönmez) + rulman yatakları; 2 vidalı kapaklar
    - Eklem sırası: somun | dış burç | rot başı | iç burç | kol | ...; burçlar boydan boya konik; aralık 30 mm
    - Çıkış mili tüm boyu artı kesit (uçlar Ø8 dairede)
    - Radyuslar: tavan, POM, üst plaka açıklıkları, motor kutuları, platform, kısa kol deliği, mil
    - Platformda 3 süs deliği; rot başı eğilme boşluğu ve eklem istifi kontrol raporunda
    - Motor kutuları görünümleri, parça önizlemeleri ve ilerleme dosyası güncellendi
2026-11-11 DeltaRobotV2: Pi kenar mimarisi ve malzeme listesi (BOM)
    - Mimari: beyin sunucuda; Raspberry Pi ince ama güvenli kenar (delta_edge C++ servisi):
    yörünge tamponu 50-100 Hz, son güvenlik kapısı, bekçi, acil stop, telemetri, WebRTC kamera,
    Pi dışarı bağlanır (TLS WebSocket); sanal Pi aynı protokol; ROS2 ağda yalnız rmw_zenoh ile
    - Yol haritası (F3/F4/F5) ve kurulum planı (Pi, acil stop kablolaması, ilk enerji testleri) güncellendi
    - hardware/bom.yaml -> bom.csv + bom.md; adet ve kütle CAD'den (cad/out/parts.json), CI senkron denetimi
    - Kök README mimari özeti (İngilizce)
2026-11-11 DeltaRobotV2: F0.5 CAD revizyon 4 (3 mm açıklık, plaka yarıçapı, dairesel platform)
    - Üst plakada kol açıklıkları 3 mm; rulman yatakları plakaya bağlı tek gövde
    - Plaka yarıçapı türetilir: rulman yatağı dış köşesi + 2.5 mm pay = R84.7
    - Kısa kol yukarı sınırı taraması (ikiye bölme): -70° temiz, mekanik sınır ≈ -71.6°
    - Uç platform dairesel R28; kulaklar taşar, rot başı kesiklerine gerek kalmadı
    - Kütleler, BOM, görseller ve ilerleme dosyası güncellendi
2026-11-11 DeltaRobotV2: F0.5 CAD revizyon 5 (rulman yatağı ayrımı ters)
    - Yatağın üst yarısı üst plakayla tek parça; alt yarı ayrı kapak, alttan takılır
    - Kapak vidaları alttan, başları aşağıda (baskıya diş / insert: varsayım); M3 x 21
    - Rulman ve mil alttan yerleştirilir; kurulum planı sırası güncellendi
    - Görseller (alttan yakın plan, parça önizlemeleri), BOM ve ilerleme güncellendi
2026-11-11 DeltaRobotV2: F0.5 CAD revizyon 6 (ısıyla gömülen insertler)
    - Yatak üst yarılarında M3 ısıyla gömülen insertler (Ø4.6 x 5.7, varsayım); kapak vidaları bunlara girer
    - Yatak genişliği 36 mm, vida konumu ±14.5 mm (insert yuvaya ve kenara değmez)
    - Plaka payı 1 mm: R85.2; 2.5 mm payda uzun kollar -69.5°'de plakayı sıyırıyordu
    - Yukarı sınır: -70° temiz, mekanik ≈ -71.2°; BOM 29 kalem; kurulum planına insert adımı
2026-11-11 DeltaRobotV2: F1 kinematik çekirdeği
    - delta_core (C++17): ileri/ters kinematik, Jacobian, koşul sayısı, rot başı açısı, limit kontrolü
    - config/robot.yaml okuyucu (yaml-cpp); rot başı limiti 13° (varsayım, V1: 14°)
    - pybind11 Python bağlaması (delta_core_py)
    - Testler: 22 GoogleTest, 495 Python (Hypothesis özellik testleri + 486 V1 çapraz doğrulama vakası), 15 araç testi
    - Kapsama: gcovr + pytest-cov, genel taban %80; CI artefaktı; çekirdek satır %100
    - Güvenlik gereksinimleri (G1-G12, 4/12 kanıtlandı) ve donanım kabul testleri (H1-H12) belgelendi
2026-11-11 DeltaRobotV2: F2 etkileşimli datasheet
    - docs/datasheet/datasheet.html: Plotly ile 3B çalışma alanı, XY dilimleri, XZ/YZ kesitleri (V1 tarzı),
    kullanılabilir silindir, çözünürlük/hız/kuvvet/koşul sayısı haritaları, tabla yüksekliğinde erişim,
    geometri, motor/elektrik, CAD kütle/atalet, BOM özeti, ROS2 ağı iskeleti, varsayımlar
    - tools/datasheet: robot.yaml + delta_core + CAD + BOM'dan üretilir; motor parametrelerine göre parametrik
    - robot.yaml: motor sürekli tork oranı, elektrik ve görev yükseklikleri (varsayım)
    - 10 yeni test; araç kapsaması %97.5; geliştirme imajına Beast/OpenSSL/json/clang/plotly
2026-11-12 DeltaRobotV2: F3 ara kayıt (Pi kenar servisi, ROS2 yığını)
    - edge/: delta_edge C++17 (ROS'suz): katı protokol v1, son güvenlik kapısı, yörünge oynatıcı,
    kalp atışı bekçisi (T_stop 200 ms / T_off 1000 ms), durum makinesi, MockDriver, TLS WebSocket istemcisi;
    102/102 test, satır kapsaması %98.9 (kapı/bekçi/protokol %98)
    - ros2_ws/: delta_interfaces, delta_description (CAD mesh'li URDF), delta_server (planlayıcı,
    1. kapı süpervizörü, durum yayıncısı, geçici sim_executor); 58/58 birim + 3/3 launch_testing, kapsama %93
    - RViz ekran görüntüleri (4), docker/ros imajı, yerel TLS sertifika betiği
    - Yeniden başlatma sonrası kurtarma: 2 derleme hatası ve 2 h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
2026-11-12 DeltaRobotV2: donanım bekçisi (G13) — mimari, gereksinim, kabul testi H13, kurulum, BOM
2026-11-12 DeltaRobotV2 F4 ara kayıt: API, Python istemcisi, web arayüzü, sandbox koşucusu, G14 zemin kapısı
    - api/: FastAPI ağ geçidi (REST + WS, belirteç, kontrol kilidi, iş kuyruğu), sahte ve ROS2 arka uçları; 40 test
    - client/: pip paketi delta-robot-client (HTTPS + sandbox stdio taşıması); 88 test, %100 kapsama
    - web/: Türkçe tek sayfa arayüz (CodeMirror editör, three.js ikiz, telemetri, elle sürme); 16 test
    - sandbox/: koşucu + kullanıcı kodu imajı, G11 testleri (doğrulama sürüyor)
    - Kenar telemetrisine mıknatıs durumu; edge_bridge magnet/stop servisleri; EdgeStatus.magnet
    - G14: mıknatıs ucu tabla/zemin altına inemez (1. kapı), 3 test
    - docs/api.md bileşen söz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
2026-11-12 DeltaRobotV2 F4.5 ara kayıt: kaydırmalı tic-tac-toe tablası, taş ikizi, API/istemci tabla yöntemleri
    - board_game.py (saf): tabla geometrisi robot.yaml task.board'dan, mıknatısla al/bırak taş ikizi,
    oyun kuralları (Üç Taş ailesi; çalışma alanı taş deposuna yer bırakmıyor), minimaks; 15 test
    - board_twin düğümü: /board/state, /board/reset, taş marker'ları
    - API GET /board, POST /board/reset; istemci board(), reset_board(), cell_xy(), pick_place()
    - Koşucu RPC yöntemleri genişledi; run_tests.sh temizliği zaman aşımlı
    - API 44, istemci 99, ROS 97 + 3, sandbox birim 81 test geçti
2026-11-12 DeltaRobotV2 ara kayıt: F5 yazılım yarısı (AX-12A arka ucu), F6 simülasyon arka ucu, tek sayfa arayüz (sürüyor)
    - F5: Dynamixel Protokol 1.0 katmanı, POSIX seri port (flock + TIOCEXCL), AX-12A sürücüsü,
    motor yapılandırması (motor_ax12.yaml), delta_servo_tool; sahte servo hattıyla 190/190 kenar testi
    - F5 belgeleri: kurulum planı servo/Pi/systemd/kalibrasyon adımları, kabul testi ön doğrulamaları
    S1-S8; BOM'da F5 askıda notu
    - F6: API simülasyon modu (ziyaretçi başına anonim oturum, hız/kapasite sınırı, boşta silme),
    FK/IK önizleme, eklem uzayında hareket, otomatik tic-tac-toe; 67 API testi
    - F6 kapsam değişikliği: kiralama sitesi iptal; SiteAuth/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
2026-11-12 DeltaRobotV2 F6 tamam: tek sayfalık deneyim arayüzü (otomatik tic-tac-toe + manuel FK/IK)
    - web/: üyeliksiz tek sayfa; anonim oturum, 3B ikiz (CAD mesh), Otomatik (başlat/durdur/sıfırla,
    hamle listesi, tabla şeması) ve Manuel (motor açısı kaydırıcıları -> FK, XYZ -> IK, Git, DUR)
    - Playwright uçtan uca (tests/ui/, konteynerde): gerçek simülasyon API'sine karşı 11/11
    - Ekran görüntüleri gerçek simülasyondan: web/screenshots/otomatik.png, manuel.png
    - Sahte sunucu F6 sözleşmesine güncellendi (kinematik ve kapı Python portu, delta_core ile eşleşir)
    - demo profili: IP başına oturum sınırı ve simülasyon hızı ortamdan ayarlanabilir
2026-11-12 DeltaRobotV2 kapanış koşusu: G11 59/59, F4/F4.5 uçtan uca 21/21, F3 uçtan uca 16/16
    Docker Desktop yeniden başlatıldıktan sonra bekleyen koşular yapıldı; bulunan üç hata düzeltildi:
    - api ile server yalnız ağ ad alanını paylaşıyordu; Fast DDS katılımcı kimlikleri çakıştı ve API
    robot durumunu alamadı. Compose: server ipc shareable, api ipc service:server
    - API /stop kenara 'stop' gönderiyordu (IDLE'da kalıyor); sözleşmedeki HOLDING için 'hold'
    - Hareket 'bitti' yanıtı servo takip gecikmesi oturmadan veriliyordu; API konum oturmasını bekler
    - Güvenlik: 12/14 gereksinim tüm yazılım katmanlarında kanıtlandı (G1-G11, G14)
    - Datasheet senaryo metrikle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
2026-11-12 DeltaRobotV2: CAD parça kütüphanesi (cad/lib) eklendi
    Kök .gitignore'daki genel lib/ kuralı cad/lib/ klasörünü dışlıyordu;
    build.py bu modüllere bağlı olduğu için CAD GitHub'dan yeniden
    üretilemiyordu. V2 .gitignore'una istisna eklendi.
